Alfaa123/Volvo-CAN-Gauge/Sniffing/RX List.txt

ID       DLC Data                    Period Count  Comment
021204B8 8   11 00 00 00 00 00 00 00 30     184057 Turn Signals
03C3F7FC 8   78 00 00 00 1B 20 D8 05 31     170711 Ignition Status
043010B8 8   00 00 00 00 00 00 28 12 40     128158 
04A0409E 8   40 41 00 00 00 00 01 90 43     114894 
05704000 8   C0 20 00 00 00 00 00 00 99     99622  Center Console Buttons
065373BA 8   85 00 22 FF 00 00 01 90 50     106009 Door And Lock Status
0730302E 8   00 00 00 00 00 42 52 F0 50     102128 
080030AE 8   80 00 03 40 11 03 52 F1 50     102961 
08E2300E 8   80 82 68 AC FF 04 00 18 75     101577 Center Console Phone
09C050B8 8   4F 00 0A 00 00 16 00 4C 52     91376  Gauge Stuff and Milage Counter | B1N2=Brighness | B2=Milage Increment | B4&B5 = Tacho B6N1=Some Messages CRITICAL FOR CLUSTER
0A90F698 8   FA FF 00 00 80 00 00 00 50     94666  Belt Minder
0C505226 8   00 32 00 00 00 00 00 B0 60     88124  FROM GAUGE CLUSTER Fasten Belt Sign and Radio Beeps
0C800010 8   00 00 00 00 00 00 00 00 103    49960  
0CB00080 8   00 00 00 00 00 00 00 00 100    50044  
0E03D7F8 8   C0 21 04 26 01 01 00 00 151    66279  Exterior lights symbols
0EE0500A 8   00 30 00 01 00 07 00 27 101    50799  Airbag Light CRITICAL FOR CLUSTER
1093F7FC 8   02 3C 89 00 3C 00 00 00 248    8029   CRITICAL FOR CLUSTER
1163F7FC 8   07 01 02 00 01 01 01 02 249    19848  Door Sensors
12404002 8   48 48 00 00 80 00 18 08 191    42086  Ac Settings
13F041BA 8   00 D0 1D 50 00 01 C0 75 102    37272  Clock/Time
15B04028 8   0F 00 00 00 00 00 00 00 120    24822  Anti Skid Light
16124008 8   00 92 00 00 00 04 00 00 97     38201  TPMS Light
16801028 8   48 00 00 79 00 00 00 78 233    32269  ABS/Brake Failure Light
1760E008 8   18 00 84 00 00 80 00 00 153    29186  Gauge Cluster Speed and Warning Lights
18805048 8   00 00 00 00 00 00 00 00 97     45185  
19F010FC 8   99 2C 00 60 01 90 DE 24 201    25299  Cruise Control Buttons
1A621000 8   0C 00 00 00 00 00 00 00 194    20067  
1AD10068 8   00 04 00 52 B3 B8 4C 95 600    12205  B1=Fuel Level B2=0x04 when cluster on 0x07 when cluster off | B7&B8 = Counting up (message ordering?)
1BD00004 8   00 00 00 00 00 00 00 00 201    24115  FROM CLUSTER
1C810066 8   20 09 90 72 02 24 00 00 350    13847  
1D604008 8   00 17 14 00 00 00 00 00 1088   13943  
1E30104A 8   40 00 06 40 40 00 00 00 455    10425  Remote Battery Message
1E900004 8   00 00 00 00 00 00 9D 28 501    10373  Settings Reset
1EF00066 8   00 00 00 00 40 00 00 30 601    8813   Turns on and off with igntion FROM GAUGE CLUSTER
1F600008 8   00 E0 00 D8 00 DC 00 D2 492    9673
