Alfaa123/Volvo-CAN-Gauge/Far.jpg

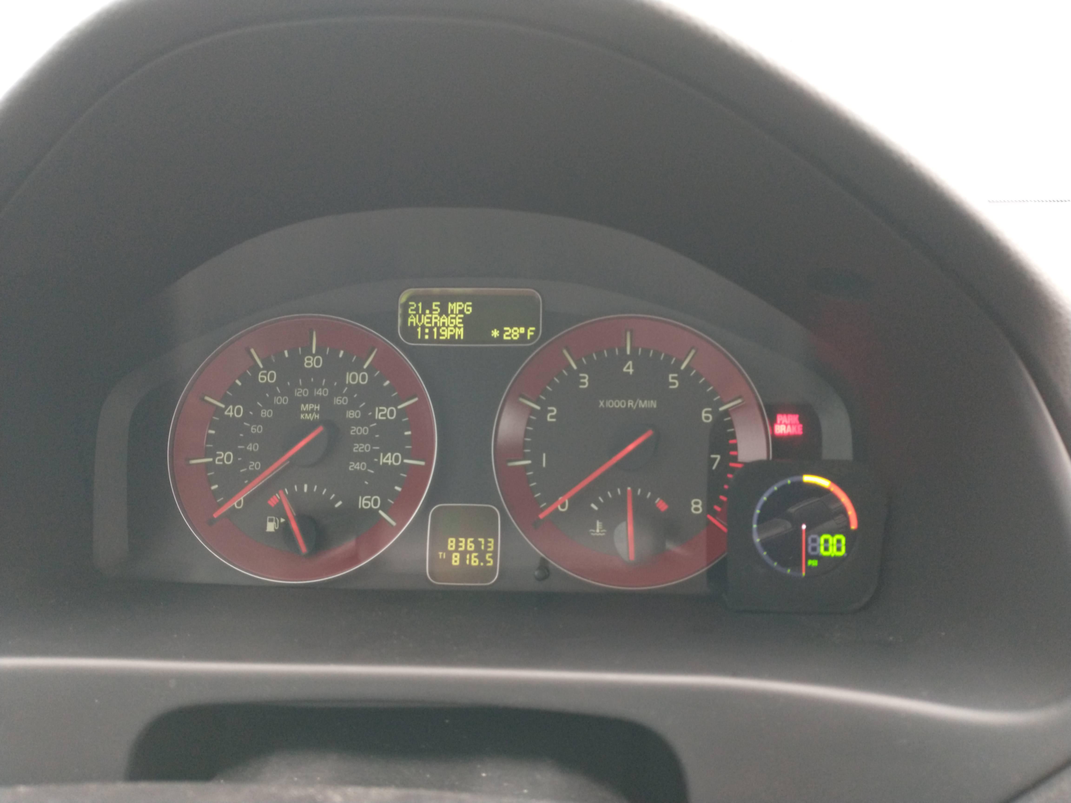
Far.jpg
