Alfaa123/Volvo-CAN-Gauge/Display Mount/Display Mount.stl

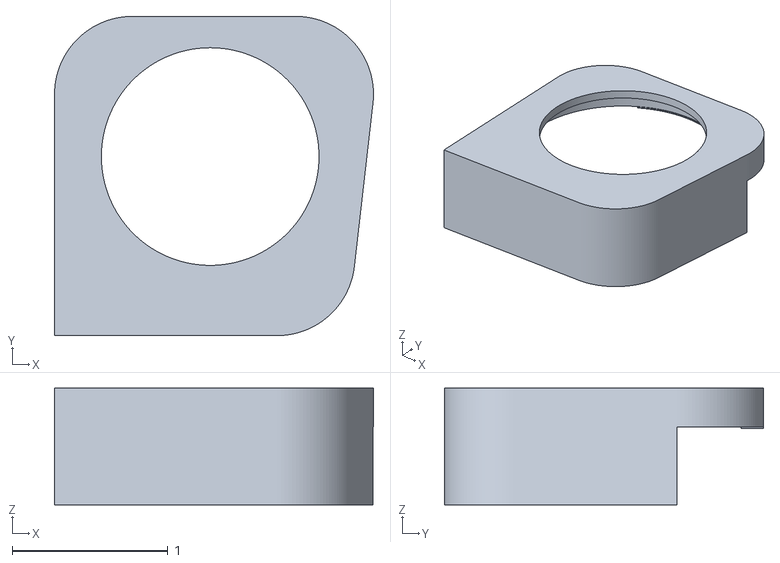
[picture p11: CAD file, 2021-02-18]
Display Mount/Display Mount.stl
2.05 x 2.05 x 0.75
