Alfaa123/Volvo-CAN-Gauge/Sniffing/Logs/Test log.csv

Time Stamp | ID | Extended | Dir | Bus | LEN | D1 | D2 | D3 | D4 | D5 | D6 | D7 | D8
607866725 | 0C505226 | true | Rx | 1 | 8 | 60 | 00 | 00 | 00 | 00 | 00 | 00 | 00
607867905 | 1EF00066 | true | Rx | 1 | 8 | 00 | 00 | 00 | 00 | 00 | 00 | 00 | 00
607881780 | 1BF00000 | true | Rx | 1 | 8 | 00 | 00 | 00 | 00 | 00 | 00 | 00 | 10
607901895 | 1BF00000 | true | Rx | 1 | 8 | 00 | 00 | 00 | 00 | 00 | 00 | 00 | 10
607921900 | 1BF00000 | true | Rx | 1 | 8 | 00 | 00 | 00 | 00 | 00 | 00 | 00 | 10
607926751 | 0C505226 | true | Rx | 1 | 8 | 80 | 37 | 00 | 00 | 00 | 00 | 00 | B0
607941901 | 1BF00000 | true | Rx | 1 | 8 | 00 | 00 | 00 | 00 | 00 | 00 | 00 | 10
607961903 | 1BF00000 | true | Rx | 1 | 8 | 00 | 00 | 00 | 00 | 00 | 00 | 00 | 10
607981907 | 1BF00000 | true | Rx | 1 | 8 | 00 | 00 | 00 | 00 | 00 | 00 | 00 | 10
607986735 | 0C505226 | true | Rx | 1 | 8 | C0 | 32 | 00 | 00 | 00 | 00 | 00 | B0
608001907 | 1BF00000 | true | Rx | 1 | 8 | 00 | 00 | 00 | 00 | 00 | 00 | 00 | 10
608021918 | 1BF00000 | true | Rx | 1 | 8 | 00 | 00 | 00 | 00 | 00 | 00 | 00 | 10
608041921 | 1BF00000 | true | Rx | 1 | 8 | 00 | 00 | 00 | 00 | 00 | 00 | 00 | 10
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
