Alfaa123/Volvo-CAN-Gauge/(commit log)

2020-09-21 Added 4D Systems Display Project
    [NoName1.cfg, VolvoBoostGauge.cfg]
2021-02-18 Create Display Mount.stl
    [Display Mount.stl]
2021-02-19 Added Ignition Angle. Changed a few generic items.
    [VolvoBoostGauge.cfg]
2021-02-23 Sniffing Updates
    [Test log.csv]
2021-02-26 Testing and Bug Fixes for Due Port
    [Volvo-CAN-Gauge.ino]
2022-04-16 Cleaned up Log directory and comment files.
    [Test log.csv]
2022-06-12 Added wiring diagram
2022-06-14 Changed boost request frame in light of new information about requests.
