Alfaa123/Volvo-CAN-Gauge/Close_Up.jpg

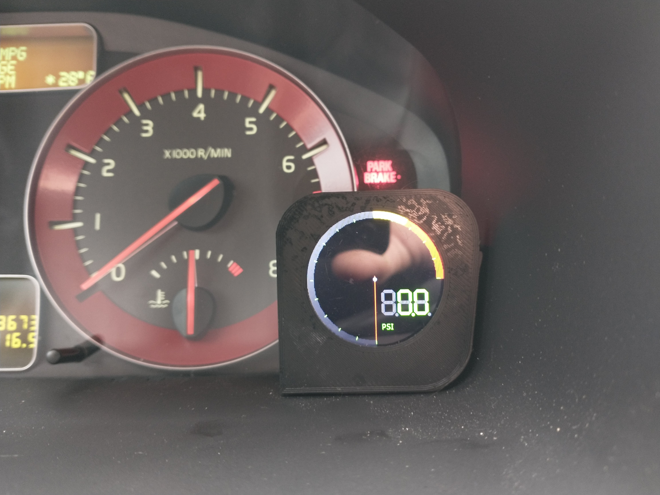
[picture p1: Close_Up.jpg]
Close_Up.jpg
